Nannaphat31108/Smartfarm/README.md

# Smart Farm 🌱

เว็บแอปควบคุมฟาร์มอัจฉริยะผ่านมือถือ (ESP32) — ควบคุมไฟ ปั๊มน้ำ และดูค่าเซนเซอร์ได้ทุกที่ ทุกเวลา

เป็นเว็บแบบ static (HTML/CSS/JS ล้วน ไม่ต้อง build) เปิด `index.html` ได้ทันที หรือเปิดใช้ GitHub Pages ได้เลย

## หน้าจอ
- **หน้าแรก** — เริ่มต้นใช้งาน
- **หน้าหลัก** — อุณหภูมิ ความชื้นอากาศ ความชื้นดิน, ควบคุมด่วน (ไฟ/ปั๊ม/อัตโนมัติ/แจ้งเตือน), ค่าเซนเซอร์
- **อุปกรณ์** — ค้นหา + กรอง (ควบคุม/เซนเซอร์), สวิตช์เปิด-ปิดรีเลย์
- **ไฟปลูกต้นไม้** — โหมดตามเวลา / ตามแสง / สั่งเอง, ตั้งเวลา
- **ปั๊มน้ำ** — เกจความชื้นดิน, ปรับเกณฑ์รดน้ำอัตโนมัติ, รดน้ำทันที
- **อัตโนมัติ** — เพิ่ม/แก้ไข/ลบ/เปิด-ปิดกฎ (ตั้งเวลา, ความชื้นดิน, แสงน้อย, อุณหภูมิสูง)
- **กล้อง** — ภาพสดจาก ESP32-CAM, ถ่ายภาพ, แฟลช, ปรับความละเอียด, ถ่ายอัตโนมัติ (ไทม์แลปส์), แกลเลอรีภาพ (ดาวน์โหลด/ลบ), โหมดเต็มจอ
- **ข้อมูล** — กราฟย้อนหลัง 24 ชม. / 7 วัน และสรุปค่าเซนเซอร์

การตั้งค่าและข้อมูลถูกเก็บไว้ใน `localStorage` ของเบราว์เซอร์

## ติดตั้งเป็นแอป

### Android (APK)
ทุกครั้งที่ push ขึ้น `main` GitHub Actions จะ build แอปให้อัตโนมัติ
ดาวน์โหลดได้ที่ **[Releases → android-latest](../../releases/tag/android-latest)** → `SmartFarm.apk` แล้วเปิดในมือถือเพื่อติดตั้ง

แอป Android ต่อ ESP32 / ESP32-CAM ผ่าน `http://` ในวง Wi-Fi บ้านได้โดยตรง (ไม่ติดปัญหา https เหมือนเปิดผ่านเว็บ)

build เองในเครื่อง (ต้องมี Android Studio):
```bash
npm install
npm run build && npx cap add android && scripts/prepare-android.sh
npx cap sync android && npx cap open android
```

### Google Play
ดูขั้นตอนทั้งหมดใน **[docs/google-play.md](docs/google-play.md)** (สร้าง upload key → ใส่ GitHub Secrets → ได้ไฟล์ `.aab`)

### iPhone / Android แบบ PWA
เปิดเว็บ (เช่นลิงก์ Render) → iPhone: Safari → แชร์ → *เพิ่มไปยังหน้าจอโฮม* · Android: Chrome จะขึ้นปุ่ม **ติดตั้ง** ที่หน้าหลัก
แอปแบบ PWA เปิดได้แม้ไม่มีเน็ต (ข้อมูลจริงยังต้องต่อ ESP32)

## เชื่อมต่อ ESP32
ค่าเริ่มต้นเป็น **โหมดจำลอง** (สุ่มค่าเซนเซอร์ให้) — เปลี่ยนเป็นข้อมูลจริงได้ที่หน้า ไฟปลูก/ปั๊มน้ำ → เมนู ⋮ → *ตั้งค่าการเชื่อมต่อ ESP32* แล้วใส่ URL เช่น `http://192.168.1.50`

ESP32 ต้องมี endpoint (และเปิด CORS):

| Method | Path | ข้อมูล |
|---|---|---|
| GET | `/sensors` | `{"temp":31.2,"hum":68,"soil":46,"lux":12400,"light":true,"pump":false}` |
| POST | `/relay` | `{"channel":1,"on":true}` (ช่อง 1 = ไฟ, ช่อง 2 = ปั๊ม, มี `minutes` เมื่อสั่งรดน้ำ) |
| GET/POST | `/config` | กฎอัตโนมัติ (แอปส่งให้เองเมื่อแก้กฎ) |

> หมายเหตุ: หากเว็บเปิดผ่าน HTTPS (เช่น GitHub Pages) เบราว์เซอร์จะบล็อกการเรียก `http://` ใน LAN — ให้เปิดไฟล์ในเครื่องหรือโฮสต์บน ESP32 เอง

## ต่อวงจรและบอร์ด ESP32 ตัวหลัก
ในแอปมีหน้า **ต่อวงจรและวิธีทำ** (หน้าหลัก → คู่มือต่อวงจร หรือหน้าอุปกรณ์) — แผนผัง, ต่อทีละชิ้น, รายการอุปกรณ์พร้อมราคาประมาณ, 12 ขั้นตอนพร้อมเช็กลิสต์ และค่าดิบสำหรับคาลิเบรต
สรุปสำหรับอ่านบน GitHub: **[docs/wiring.md](docs/wiring.md)** · โค้ดบอร์ด: `firmware/smartfarm/smartfarm.ino`

เมื่อเชื่อมบอร์ดจริง แอปจะส่งกฎอัตโนมัติไปเก็บที่บอร์ด (`POST /config`) — **บอร์ดรดน้ำ/เปิดไฟเองแม้ปิดแอปหรือเน็ตหลุด**

## กล้อง ESP32-CAM
1. เปิด `firmware/esp32cam/esp32cam.ino` ใน Arduino IDE แก้ `WIFI_SSID` / `WIFI_PASS`
2. เลือกบอร์ด **AI Thinker ESP32-CAM** (ESP32 core 2.x ขึ้นไป) แล้วอัปโหลด (ต่อ GPIO0 ลง GND ตอนแฟลช)
3. เปิด Serial Monitor (115200) จะเห็น IP เช่น `http://192.168.1.60`
4. ในเว็บ ไปที่แท็บ **กล้อง** → *การเชื่อมต่อ* → ใส่ IP นั้น

| Path | ใช้ทำอะไร |
|---|---|
| `GET :81/stream` | ภาพสด MJPEG |
| `GET /capture` | ถ่ายภาพนิ่ง (ต้องมี header `Access-Control-Allow-Origin: *`) |
| `GET /control?var=framesize&val=8` | ความละเอียด (5=QVGA, 8=VGA, 9=SVGA, 11=HD) |
| `GET /control?var=led_intensity&val=255` | แฟลช (0–255) |

ใช้กับตัวอย่าง *CameraWebServer* ของ Arduino ได้เช่นกัน ภาพที่ถ่ายเก็บในเบราว์เซอร์สูงสุด 12 ภาพ (ลดขนาดเหลือกว้าง 640px)
ESP32-CAM ส่งภาพสดได้ทีละ 1 เครื่อง — ถ้าเปิดหลายจอพร้อมกันจอที่สองจะไม่ขึ้นภาพ

อุปกรณ์อ้างอิง: รีเลย์ 2 ช่อง, Capacitive soil sensor (GPIO34), SHT40 (I2C, ตัวหลัก), DHT22 (GPIO4, ตัวสำรอง), BH1750 (I2C), ESP32-CAM (OV2640)
