Nannaphat31108/Smartfarm/firmware/smartfarm/smartfarm.ino

/*
 * Smart Farm — ESP32 ตัวหลัก (เซนเซอร์ + รีเลย์ + ระบบอัตโนมัติ)
 *
 * บอร์ด: ESP32 DevKit V1 (ESP32-WROOM-32) · Arduino IDE + ESP32 core 3.x
 * ไลบรารี (Library Manager): Adafruit SHT4x Library, DHT sensor library, Adafruit Unified Sensor,
 *                          BH1750 (Christopher Laws), ArduinoJson (v7)
 *
 * อุณหภูมิ/ความชื้นอากาศ: ใช้ SHT40 เป็นตัวหลัก (แม่นกว่า) ถ้าไม่พบหรืออ่านไม่ได้จะใช้ DHT22 แทนอัตโนมัติ
 * ต่อแค่ตัวใดตัวหนึ่งก็ได้
 *
 * ระบบอัตโนมัติทำงานบนบอร์ดนี้เอง — ปิดแอปหรือเน็ตหลุดก็ยังรดน้ำ/เปิดไฟตามกฎ
 * แอปเป็นแค่ตัวตั้งค่าและดูผล (ส่งกฎมาที่ POST /config)
 *
 * API (พอร์ต 80, เปิด CORS):
 *   GET  /sensors   ค่าเซนเซอร์ + สถานะรีเลย์ (JSON)
 *   POST /relay     {"channel":1|2, "on":true|false, "minutes":3}
 *   GET  /config    กฎอัตโนมัติปัจจุบัน
 *   POST /config    บันทึกกฎอัตโนมัติ (เก็บในหน่วยความจำถาวร)
 */
#include <WiFi.h>
#include <WebServer.h>
#include <ESPmDNS.h>
#include <Preferences.h>
#include <Wire.h>
#include <time.h>
#include <DHT.h>
#include <Adafruit_SHT4x.h>
#include <BH1750.h>
#include <ArduinoJson.h>

// ======================= ตั้งค่าที่ต้องแก้ =======================
const char *WIFI_SSID = "YOUR_WIFI";
const char *WIFI_PASS = "YOUR_PASSWORD";
const char *HOSTNAME = "smartfarm";  // เข้าได้ที่ http://smartfarm.local (ถ้าเครือข่ายรองรับ)

// คาลิเบรตเซนเซอร์ความชื้นดิน: เปิด http://<IP>/sensors ดูค่า soilRaw
const int SOIL_DRY = 3000;  // ค่า soilRaw ตอนเซนเซอร์อยู่ในอากาศ/ดินแห้งสนิท
const int SOIL_WET = 1300;  // ค่า soilRaw ตอนจุ่มน้ำ (ถึงขีดบนของเซนเซอร์)
const int SOIL_RAW_MIN = 200;   // ต่ำกว่านี้ถือว่าสายหลุด/ช็อต
const int SOIL_RAW_MAX = 3900;  // สูงกว่านี้ถือว่าไม่ได้ต่อเซนเซอร์

// โมดูลรีเลย์ส่วนใหญ่ทำงานเมื่อขา IN เป็น LOW
const bool RELAY_ACTIVE_LOW = true;

const int PUMP_MAX_MINUTES = 30;       // กันปั๊มทำงานนานเกินไป
const int SOIL_RULE_COOLDOWN_MIN = 30; // รดน้ำตามความชื้นดินแล้ว รออย่างน้อยกี่นาทีก่อนรดซ้ำ
// =============================================================

// ขาที่ใช้ (ดูหน้า "ต่อวงจร" ในแอป)
#define PIN_DHT 4
#define PIN_SOIL 34
#define PIN_RELAY_LIGHT 26
#define PIN_RELAY_PUMP 27
#define PIN_LED 2
#define PIN_SDA 21
#define PIN_SCL 22

DHT dht(PIN_DHT, DHT22);
BH1750 lightMeter;
WebServer server(80);
Preferences prefs;

// ---------- state ----------
struct Sensors {
  float temp = NAN, hum = NAN, lux = NAN;
  int soilRaw = 0;
  float soil = NAN;
} S;

bool lightOn = false, pumpOn = false;
unsigned long pumpUntil = 0;        // millis() ที่ปั๊มต้องหยุด
unsigned long pumpStartedAt = 0;
unsigned long lastSoilWatering = 0; // millis() ที่รดน้ำตามความชื้นดินล่าสุด
bool hasWateredBySoil = false;
float lightMinutesToday = 0, pumpMinutesToday = 0;
int counterDay = -1;
bool bh1750Ok = false;
bool sht40Ok = false;
Adafruit_SHT4x sht4;
float shtT = NAN, shtH = NAN, dhtT = NAN, dhtH = NAN;

// กฎอัตโนมัติ (ค่าเริ่มต้นเหมือนในแอป)
JsonDocument config;
const char *DEFAULT_CONFIG = R"({
  "auto": true, "threshold": 40, "duration": 3, "lightMode": "schedule", "soilRule": true,
  "lightSchedules": [{"start":"18:00","end":"22:00","days":"daily","on":true}],
  "pumpSchedules": [{"start":"06:30","duration":5,"days":"daily","on":true},
                    {"start":"17:00","duration":3,"days":"weekdays","on":true}],
  "lux": {"on": false, "value": 5000, "start": "06:00", "end": "18:00"}
})";
String firedKeys[8];  // กันรอบรดน้ำตามเวลาซ้ำในนาทีเดียวกัน

// ---------- relays ----------
void writeRelay(int pin, bool on) {
  digitalWrite(pin, (on ^ RELAY_ACTIVE_LOW) ? HIGH : LOW);
}

void setLight(bool on) {
  if (lightOn == on) return;
  lightOn = on;
  writeRelay(PIN_RELAY_LIGHT, on);
  Serial.printf("[light] %s\n", on ? "ON" : "OFF");
}

void startPump(float minutes, const char *reason) {
  minutes = constrain(minutes, 0.1f, (float)PUMP_MAX_MINUTES);
  if (!pumpOn) pumpStartedAt = millis();
  pumpOn = true;
  pumpUntil = millis() + (unsigned long)(minutes * 60000UL);
  writeRelay(PIN_RELAY_PUMP, true);
  Serial.printf("[pump] ON %.1f min (%s)\n", minutes, reason);
}

void stopPump(const char *reason) {
  if (!pumpOn) return;
  pumpOn = false;
  writeRelay(PIN_RELAY_PUMP, false);
  Serial.printf("[pump] OFF (%s)\n", reason);
}

// ---------- sensors ----------
void readSensors() {
  // SHT40 (หลัก) + DHT22 (สำรอง)
  shtT = shtH = NAN;
  if (sht40Ok) {
    sensors_event_t hum, temp;
    if (sht4.getEvent(&hum, &temp)) {
      shtT = temp.temperature;
      shtH = hum.relative_humidity;
    }
  }
  float t = dht.readTemperature(), h = dht.readHumidity();
  if (!isnan(t)) dhtT = t;
  if (!isnan(h)) dhtH = h;
  S.temp = !isnan(shtT) ? shtT : dhtT;
  S.hum = !isnan(shtH) ? shtH : dhtH;

  long sum = 0;
  for (int i = 0; i < 10; i++) { sum += analogRead(PIN_SOIL); delay(2); }
  S.soilRaw = sum / 10;
  // ค่านอกช่วงนี้ = สายหลุด/ไม่ได้ต่อ → ไม่ใช้ค่า (กันรดน้ำผิดพลาด)
  if (S.soilRaw < SOIL_RAW_MIN || S.soilRaw > SOIL_RAW_MAX) S.soil = NAN;
  else S.soil = constrain(map(S.soilRaw, SOIL_DRY, SOIL_WET, 0, 100), 0, 100);

  if (bh1750Ok) {
    float lx = lightMeter.readLightLevel();
    if (lx >= 0) S.lux = lx;
  }
}

// ---------- time helpers ----------
bool timeReady(struct tm &now) {
  return getLocalTime(&now, 10) && now.tm_year > 120;
}
int toMin(const char *hhmm) {
  if (!hhmm) return -1;
  return atoi(hhmm) * 60 + atoi(hhmm + 3);
}
bool dayMatches(const char *days, int wday) {
  if (days && !strcmp(days, "weekdays")) return wday >= 1 && wday <= 5;
  if (days && !strcmp(days, "weekends")) return wday == 0 || wday == 6;
  return true;
}
bool inWindow(const char *start, const char *end, int nowMin) {
  int s = toMin(start), e = toMin(end);
  if (s < 0 || e < 0) return false;
  return s <= e ? (nowMin >= s && nowMin < e) : (nowMin >= s || nowMin < e);
}

// ---------- automation (every second) ----------
void automation() {
  static unsigned long last = 0;
  unsigned long dt = millis() - last;
  if (dt < 1000) return;
  last = millis();

  if (lightOn) lightMinutesToday += dt / 60000.0f;
  if (pumpOn) pumpMinutesToday += dt / 60000.0f;

  // pump timer + safety
  if (pumpOn && (long)(millis() - pumpUntil) >= 0) stopPump("ครบเวลา");

  struct tm now;
  bool clock = timeReady(now);
  if (clock && now.tm_yday != counterDay) {  // ขึ้นวันใหม่ รีเซ็ตตัวนับ
    counterDay = now.tm_yday;
    lightMinutesToday = pumpMinutesToday = 0;
  }
  if (!config["auto"].as<bool>()) return;

  int nowMin = clock ? now.tm_hour * 60 + now.tm_min : -1;
  const char *mode = config["lightMode"] | "schedule";
  JsonObject lux = config["lux"];

  // light
  if (!strcmp(mode, "schedule") && clock) {
    bool want = false;
    for (JsonObject r : config["lightSchedules"].as<JsonArray>()) {
      if (r["on"] && dayMatches(r["days"], now.tm_wday) && inWindow(r["start"], r["end"], nowMin)) want = true;
    }
    if (!want && lux["on"] && !isnan(S.lux) && S.lux < (lux["value"] | 5000) && inWindow(lux["start"], lux["end"], nowMin)) want = true;
    setLight(want);
  } else if (!strcmp(mode, "light") && !isnan(S.lux)) {
    bool window = clock ? inWindow(lux["start"] | "06:00", lux["end"] | "18:00", nowMin) : true;
    setLight(S.lux < (lux["value"] | 5000) && window);
  }

  // pump: schedules
  if (clock) {
    int i = 0;
    for (JsonObject r : config["pumpSchedules"].as<JsonArray>()) {
      if (i >= 8) break;
      char key[24];
      snprintf(key, sizeof(key), "%d-%d", now.tm_yday, nowMin);
      if (r["on"] && dayMatches(r["days"], now.tm_wday) && toMin(r["start"]) == nowMin && firedKeys[i] != key) {
        firedKeys[i] = key;
        if (!pumpOn) startPump(r["duration"] | 3, "ตามเวลา");
      }
      i++;
    }
  }

  // pump: soil moisture rule
  if (config["soilRule"] && !pumpOn && !isnan(S.soil) && S.soil < (config["threshold"] | 40)) {
    bool cooled = !hasWateredBySoil || millis() - lastSoilWatering > SOIL_RULE_COOLDOWN_MIN * 60000UL;
    if (cooled) {
      hasWateredBySoil = true;
      lastSoilWatering = millis();
      startPump(config["duration"] | 3, "ดินแห้ง");
    }
  }
}

// ---------- config storage ----------
void loadConfig() {
  prefs.begin("smartfarm", true);
  String saved = prefs.getString("config", "");
  prefs.end();
  if (saved.length() == 0 || deserializeJson(config, saved)) deserializeJson(config, DEFAULT_CONFIG);
}
void saveConfig() {
  String out;
  serializeJson(config, out);
  prefs.begin("smartfarm", false);
  prefs.putString("config", out);
  prefs.end();
}

// ---------- HTTP ----------
void cors() {
  server.sendHeader("Access-Control-Allow-Origin", "*");
  server.sendHeader("Access-Control-Allow-Methods", "GET, POST, OPTIONS");
  server.sendHeader("Access-Control-Allow-Headers", "Content-Type");
}
void sendJson(int code, JsonDocument &doc) {
  String out;
  serializeJson(doc, out);
  cors();
  server.send(code, "application/json", out);
}
void sendError(int code, const char *msg) {
  JsonDocument doc;
  doc["error"] = msg;
  sendJson(code, doc);
}
template <typename T>
void setNum(T &&doc, const char *k, float v, int decimals) {
  if (isnan(v)) doc[k] = nullptr;
  else doc[k] = roundf(v * powf(10, decimals)) / powf(10, decimals);
}

void handleSensors() {
  JsonDocument doc;
  setNum(doc, "temp", S.temp, 1);
  setNum(doc, "hum", S.hum, 0);
  setNum(doc, "soil", S.soil, 0);
  setNum(doc, "lux", S.lux, 0);
  doc["soilRaw"] = S.soilRaw;
  doc["tempSource"] = !isnan(shtT) ? "sht40" : (!isnan(dhtT) ? "dht22" : nullptr);
  JsonObject sht = doc["sht40"].to<JsonObject>();
  setNum(sht, "temp", shtT, 1);
  setNum(sht, "hum", shtH, 0);
  JsonObject dh = doc["dht22"].to<JsonObject>();
  setNum(dh, "temp", dhtT, 1);
  setNum(dh, "hum", dhtH, 0);
  doc["light"] = lightOn;
  doc["pump"] = pumpOn;
  doc["pumpRemaining"] = pumpOn ? (long)(pumpUntil - millis()) / 1000 : 0;
  setNum(doc, "lightMinutesToday", lightMinutesToday, 1);
  setNum(doc, "pumpMinutesToday", pumpMinutesToday, 1);
  doc["lightMode"] = config["lightMode"];
  doc["auto"] = config["auto"];
  struct tm now;
  doc["clock"] = timeReady(now);
  doc["rssi"] = WiFi.RSSI();
  doc["uptime"] = millis() / 1000;
  sendJson(200, doc);
}

void handleRelay() {
  JsonDocument body;
  if (deserializeJson(body, server.arg("plain"))) return sendError(400, "invalid JSON");
  int ch = body["channel"] | 0;
  bool on = body["on"] | false;
  if (ch == 1) {
    // สั่งไฟเองจากแอป = เปลี่ยนเป็นโหมดสั่งเอง (ไม่ให้ตารางเวลาสั่งกลับ)
    config["lightMode"] = "manual";
    saveConfig();
    setLight(on);
  } else if (ch == 2) {
    if (on) startPump(body["minutes"] | (float)(config["duration"] | 3), "สั่งจากแอป");
    else stopPump("สั่งจากแอป");
  } else {
    return sendError(400, "channel must be 1 or 2");
  }
  handleSensors();
}

void handleGetConfig() { sendJson(200, config); }

void handlePostConfig() {
  JsonDocument incoming;
  if (deserializeJson(incoming, server.arg("plain"))) return sendError(400, "invalid JSON");
  config = incoming;
  saveConfig();
  Serial.println("[config] updated from app");
  sendJson(200, config);
}

void handleOptions() {
  cors();
  server.send(204);
}

// ---------- Wi-Fi diagnostics ----------
const char *wifiReasonText(uint8_t r) {
  switch (r) {
    case 201: case 210: case 211: case 212:
      return "หาชื่อ Wi-Fi ไม่เจอ — ตรวจ WIFI_SSID (ตัวพิมพ์เล็ก/ใหญ่, เว้นวรรค), ต้องเป็น 2.4GHz, อยู่ใกล้เราเตอร์";
    case 2: case 15: case 202: case 204:
      return "รหัสผ่านผิด — ตรวจ WIFI_PASS";
    case 203: case 205:
      return "เราเตอร์ไม่ยอมให้เชื่อม — ลองรีสตาร์ทเราเตอร์ หรือปิด MAC filter";
    case 8:
      return "ตัดการเชื่อมต่อเอง";
    default:
      return "เชื่อมต่อไม่สำเร็จ";
  }
}

void onWifiEvent(WiFiEvent_t event, WiFiEventInfo_t info) {
  if (event != ARDUINO_EVENT_WIFI_STA_DISCONNECTED) return;
  static uint8_t lastReason = 0;
  static unsigned long lastPrint = 0;
  uint8_t r = info.wifi_sta_disconnected.reason;
  if (r != lastReason || millis() - lastPrint > 15000) {  // ไม่พิมพ์ซ้ำรัว ๆ
    lastReason = r;
    lastPrint = millis();
    Serial.printf("\n[wifi] หลุด/ต่อไม่ได้ (reason %u): %s\n", r, wifiReasonText(r));
  }
}

// ---------- I2C scan (ช่วยหาว่าเซนเซอร์ต่อถูกไหม) ----------
void scanI2C() {
  Serial.print("[i2c] พบอุปกรณ์:");
  int found = 0;
  for (uint8_t addr = 1; addr < 127; addr++) {
    Wire.beginTransmission(addr);
    if (Wire.endTransmission() == 0) {
      found++;
      const char *name = addr == 0x44 || addr == 0x45 ? " (SHT40)" : (addr == 0x23 || addr == 0x5C ? " (BH1750)" : "");
      Serial.printf(" 0x%02X%s", addr, name);
    }
  }
  if (!found) Serial.print(" ไม่มีเลย — ตรวจไฟ 3V3/GND ของเซนเซอร์ และสาย SDA=GPIO21, SCL=GPIO22");
  Serial.println();
}

// ---------- คำสั่งทดสอบผ่าน Serial Monitor (ไม่ต้องใช้ Wi-Fi) ----------
// พิมพ์: light on | light off | pump on | pump off | status
void handleSerial() {
  if (!Serial.available()) return;
  String cmd = Serial.readStringUntil('\n');
  cmd.trim();
  cmd.toLowerCase();
  if (cmd.length() == 0) return;
  if (cmd == "light on" || cmd == "light off") {
    config["lightMode"] = "manual";  // กันตารางเวลาสั่งกลับ (เหมือนกดในแอป)
    saveConfig();
    setLight(cmd == "light on");
  } else if (cmd == "pump on") {
    startPump(1, "สั่งจาก Serial");
  } else if (cmd == "pump off") {
    stopPump("สั่งจาก Serial");
  } else if (cmd == "status") {
    Serial.printf("light=%s pump=%s lightMode=%s wifi=%s\n", lightOn ? "ON" : "OFF", pumpOn ? "ON" : "OFF",
                  (const char *)(config["lightMode"] | "?"),
                  WiFi.status() == WL_CONNECTED ? WiFi.localIP().toString().c_str() : "ยังไม่เชื่อมต่อ");
  } else {
    Serial.println("คำสั่ง: light on | light off | pump on | pump off | status");
  }
}

// ---------- setup / loop ----------
void connectWifi() {
  WiFi.onEvent(onWifiEvent);
  WiFi.setHostname(HOSTNAME);  // ต้องตั้งก่อน WiFi.mode() ไม่งั้นเราเตอร์จะเห็นเป็น esp32-xxxxxx
  WiFi.mode(WIFI_STA);
  WiFi.setAutoReconnect(true);
  WiFi.begin(WIFI_SSID, WIFI_PASS);
  Serial.printf("Connecting WiFi \"%s\"", WIFI_SSID);
  unsigned long start = millis();
  while (WiFi.status() != WL_CONNECTED && millis() - start < 20000) {
    digitalWrite(PIN_LED, !digitalRead(PIN_LED));
    delay(250);
    Serial.print(".");
  }
  digitalWrite(PIN_LED, WiFi.status() == WL_CONNECTED);
  if (WiFi.status() == WL_CONNECTED) {
    Serial.printf("\nSmart Farm ready: http://%s  (http://%s.local)\n", WiFi.localIP().toString().c_str(), HOSTNAME);
  } else {
    Serial.println("\nWiFi ไม่ได้ — ระบบอัตโนมัติยังทำงานต่อ จะลองต่อใหม่เรื่อย ๆ");
  }
}

void setup() {
  // ตั้งขารีเลย์แล้วสั่ง "ปิด" ทันที (ESP32 core 3.x ไม่รับ digitalWrite ก่อน pinMode
  // และ pinMode(OUTPUT) เริ่มที่ LOW = รีเลย์แบบ active-low จะเปิด ถ้าไม่สั่งปิดตรงนี้)
  pinMode(PIN_RELAY_LIGHT, OUTPUT);
  writeRelay(PIN_RELAY_LIGHT, false);
  pinMode(PIN_RELAY_PUMP, OUTPUT);
  writeRelay(PIN_RELAY_PUMP, false);
  pinMode(PIN_LED, OUTPUT);
  analogReadResolution(12);
  analogSetPinAttenuation(PIN_SOIL, ADC_11db);

  Serial.begin(115200);
  delay(200);
  Serial.println("\n=== Smart Farm ESP32 ===");

  dht.begin();
  Wire.begin(PIN_SDA, PIN_SCL);
  scanI2C();
  bh1750Ok = lightMeter.begin(BH1750::CONTINUOUS_HIGH_RES_MODE);
  sht40Ok = sht4.begin(&Wire);
  if (sht40Ok) {
    sht4.setPrecision(SHT4X_HIGH_PRECISION);
    sht4.setHeater(SHT4X_NO_HEATER);
  } else {
    Serial.println("ไม่พบ SHT40 — จะใช้ DHT22 แทน (ตรวจสาย SDA/SCL ถ้าต่อ SHT40 ไว้)");
  }
  if (!bh1750Ok) Serial.println("ไม่พบ BH1750 — ตรวจสาย SDA/SCL");

  loadConfig();
  connectWifi();
  configTzTime("ICT-7", "pool.ntp.org", "time.google.com");  // เวลาไทย
  if (MDNS.begin(HOSTNAME)) MDNS.addService("http", "tcp", 80);

  server.on("/", HTTP_GET, []() { cors(); server.send(200, "text/plain", "Smart Farm ESP32 OK — /sensors /relay /config"); });
  server.on("/sensors", HTTP_GET, handleSensors);
  server.on("/relay", HTTP_POST, handleRelay);
  server.on("/config", HTTP_GET, handleGetConfig);
  server.on("/config", HTTP_POST, handlePostConfig);
  server.on("/relay", HTTP_OPTIONS, handleOptions);
  server.on("/config", HTTP_OPTIONS, handleOptions);
  server.onNotFound([]() { sendError(404, "not found"); });
  server.begin();

  readSensors();
  Serial.println("พิมพ์คำสั่งทดสอบได้: light on | light off | pump on | pump off | status");
}

void loop() {
  server.handleClient();
  handleSerial();

  static unsigned long lastRead = 0;
  if (millis() - lastRead > 2500) {  // DHT22 อ่านได้ไม่เร็วกว่า 2 วินาที
    lastRead = millis();
    readSensors();
    Serial.printf("T=%.1f H=%.0f [SHT40 %.1f/%.0f DHT22 %.1f/%.0f] soil=%.0f%% (raw %d) lux=%.0f light=%d pump=%d\n",
                  S.temp, S.hum, shtT, shtH, dhtT, dhtH, S.soil, S.soilRaw, S.lux, lightOn, pumpOn);
  }

  automation();

  // ต่อ Wi-Fi ใหม่ถ้าหลุดนาน (ไม่เรียกซ้ำระหว่างที่กำลังเชื่อมต่อ กัน "sta is connecting" error)
  static unsigned long lastWifiCheck = 0;
  static bool wasConnected = false;
  bool connected = WiFi.status() == WL_CONNECTED;
  if (connected && !wasConnected) {
    Serial.printf("[wifi] เชื่อมต่อแล้ว: http://%s\n", WiFi.localIP().toString().c_str());
    digitalWrite(PIN_LED, HIGH);
  }
  if (!connected && wasConnected) digitalWrite(PIN_LED, LOW);
  wasConnected = connected;
  if (!connected && millis() - lastWifiCheck > 60000) {
    lastWifiCheck = millis();
    WiFi.disconnect();
    delay(100);
    WiFi.begin(WIFI_SSID, WIFI_PASS);
  }
}
