Nannaphat31108/Smartfarm/(commit log)

2026-10-06 Add Smart Farm web app (home, devices, light, pump, automation, data screens)
    Claude-Session: https://claude.ai/code/session_015wphQJ8Ri83j8ZYvS1RDGw
2026-10-06 Add ESP32-CAM camera: live stream, snapshots, flash, time-lapse, gallery
    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
2026-10-07 Make it an app: installable PWA (offline) and Android APK via Capacitor
    - manifest, service worker, icons, install banner, safe-area padding
    - Capacitor config (http scheme + cleartext so the app reaches ESP32 on LAN)
    - GitHub Actions builds SmartFarm.apk and publishes it to the android-latest release
    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
2026-10-07 Google Play release: signed AAB from GitHub Secrets, upload-key script, privacy policy
    - workflow builds bundleRelease/assembleRelease when ANDROID_KEYSTORE_BASE64 etc. are set
    - scripts/create-upload-key.sh generates the key locally (never committed)
    - privacy.html for the Play listing, docs/google-play.md step-by-step guide
    - app id changed to com.nannaphat.smartfarm (Play ids are global and permanent)
    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
2026-10-08 Main ESP32 firmware, wiring & build guide page, board-side automation
    - firmware/smartfarm: DHT22, soil, BH1750, DS18B20, JSN-SR04T, 2 relays;
    rules stored on the board (POST /config) so watering runs without the app
    - app syncs rules to the board, uses real pump timers, shows '–' for missing sensors
    - new 'ต่อวงจรและวิธีทำ' page: overview diagram, per-part wiring, parts list,
    14-step checklist, live raw values for calibration
    - docs/wiring.md, CI job that compiles both firmwares
    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
    [app.js, smartfarm.ino]
2026-10-08 Remove water tank level system (JSN-SR04T)
    - app/web: tank tiles, pump info row, data bar, low-tank alert, simulation
    - wiring guide: JSN-SR04T wiring, part, step, overview diagram, voltage divider
    - firmware: ultrasonic reading, tank constants and low-tank pump lockout
    - home tile now shows last watering time
    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
2026-10-08 Remove DS18B20 soil temperature sensor
    - app/web: soil temperature tile, device, data bar and simulation removed;
    home tile now shows the next scheduled watering
    - wiring guide: DS18B20 wiring, part, step and diagram entry removed
    - firmware: OneWire/DallasTemperature dropped (CI library list updated)
    - demo seed times always in the past
    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
2026-10-09 Add SHT40 as main air temperature/humidity sensor (DHT22 as fallback)
    - firmware: SHT40 on the shared I2C bus; temp/hum fall back to DHT22 automatically;
    /sensors reports both readings and which one is in use
    - app: devices list shows SHT40 and DHT22 separately with the active one marked
    - wiring guide, parts list, steps, overview diagram, docs and CI libraries updated
    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
2026-10-20 Full wiring guide: power rails, wire-by-wire tables, build order, pre-power checklist, troubleshooting
    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
2026-10-20 Firmware: ignore out-of-range soil readings (loose/unconnected sensor) so it can't trigger watering
    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
2026-10-20 Firmware diagnostics: print Wi-Fi failure reason, I2C scan at boot, avoid reconnect while connecting
    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
2026-10-20 Firmware: fix relays switching ON at boot (core 3.x ignores digitalWrite before pinMode); add Serial test commands
    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
2026-10-20 App: accept board IP without http://, confirm relay commands only when the board answers
    - normalise ESP32/ESP32-CAM URLs (add http://, strip trailing slash)
    - light/pump commands revert and show 'ส่งคำสั่งไม่ถึงบอร์ด' instead of a false success toast
    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
